golriz9/MarketingSpy/README.md

MarketingSpy
============

Description:
Building a system that can determine which device attracts more customers in an electronics store by counting how many times the item has been picked up, and measuring the average time of pick up. Every time the item is picked up by the customer, the sensor will detect and send the signal to the processor, the processor will process the signal, and display the cumulative count and average time on the LCD.
