golriz9/MarketingSpy/T15_DesignBlockDiagram_V1.0.docx

Design Block Diagram | Bander Alenezi
Team T15 | Anthony Do
Project Tittle: Marketing Spy | Phu Nguyen
Date: Oct 22, 2014 Revision : 1 | Golriz Sedaghat

Object (Input)

Output Display

µController

Sensor

JTAG/ICSP

Power Supply
