golriz9/MarketingSpy/T15_Preliminary_BOM_V1.0.xlsx

Quantity | Component | Manufacturer Part # | Distributer Part# | Descrption | Unit Price $ | Shipping Fee $ | Total $ | Bought From | Sum of Totals
4 | LCD Display |  | IM162 | microtivity IM162 LCD Module 1602, Black on Green with Backlight | $10.99 | $0.00 | $43.96 | AMAZON | $169.03
5 | Microcontroller | ATMEGA168A-AU | 556-ATMEGA168A-AU | 8-bit Microcontrollers - MCU AVR 16KB FL 512B EE 1KB SRAM-20MHz | $2.73 | $7.99 | $35.14 | MOUSER
5 | Voltage Regulator | L7805CV | 511-L7805CV | Linear Voltage Regulators 5.0V 1.0A Positive | $0.59 |  |  | MOUSER
5 | Crystal Oscillator | ECS-160-20-4X | 520-HCU1600-20X | Crystals 16MHz 20pF | $0.53 |  |  | MOUSER
5 | Hall Effect Sensor | SS345PT | 785-SS345PT | Board Mount Hall Effect / Magnetic Sensors SOT-23 SMT 2.7 TO 7Vdc | $1.58 |  |  | MOUSER
2 | Programmer |  |  | Atmel AVRISP Programmer ATAVRISP2 | $24.99 | 0 | $49.98 | eBay
1 | Debugger |  |  |  | $18.00 | $6.99 | $24.99 | eBay
2 | Big Button Input Module |  | BR010025 | Big Button Input Module | $1.50 | $2.32 | $3.00 | Banana Robotic
4 | Track Sensor Module |  | BR010214 | Track Sensor Module | $2.99 |  | $11.96 | Banana Robotic
5 | Voltage Regulator | L7805CDT-TR | 511-L7805CDT-TR | Linear Voltage Regulators 5.0V 1.0A Positive | $0.74 |  |  | Mouser
