golriz9/MarketingSpy/Decision_Matrix.xlsx

 | Weight and Score Key: 1-5, 1 = Failure, 2 = Insufficient, 3 = Mediocre, 4 = Satisfactory, 5 = Excellent, ? = Not enough info to decide
 | Meets the Requirements |  | Cost |  | Design |  | Manufacturing and Implementation |  | Testability |  | Time & Effort Required to Produce |  | Coolness and application |  | Total
Criterion Weight | 5 |  | 3 |  | 4 |  | 4 |  | 5 |  | 5 |  | 2
Ideas | Rationale | Score | Rationale | Score | Rationale | Score | Rationale | Score | Rationale | Score | Rationale | Score | Rationale | Score
Basketball Scorekeeper | Meets "must","should" and "may" requirement | 20 | Moderate cost, no special hardware and software are required | 11.5 | 1- Simple design 2- No special difficulties | 16 | 1. Concern about the location and mounting of the sensor. 2. Error in reading input signal in case the ball spins around the hook but not going through. | 10.5 | 1. Concern about damaging the sensor by ball 2. The pole, basket ball hooks might be required for testing | 10.5 | Does not require extensive amount of time and specialty | 16.5 | Cool, not challenging | 4.5 | 384.5
Marketing Spy | Meets "must","should" and "may" requirement | 20 | 1. The cost may be moderate. The sensor will probably be the most cost effective. 2. No special hardware and software are required | 11.5 | 1. Simple design 2. No special difficulties | 16 | No special hardness | 13.5 | No special difficulty | 17.5 | No specialty | 19 | Cool, not challenging | 4.5 | 444
Karnaugh Map Calculator | Meets "must","should" and "may" requirement | 20 | LCD cost might be high | 9 | 1. The software side of the project may be extensive 2. Complexity of coding is expected | 11.5 | 1. The wiring and soldering may require extensive amount of time. The software side of the project may be extensive as well. 2. May require more wiring and soldering as there are 3 input channel (for 3 variables K-Map) | 10.5 | 1. The testing may take a lot of time to fix the bugs. 2. Hardness in debugging: too many input combinations need to be tested | 12.5 | More time and effort required for coding and testing | 14.5 | Cool and challenging | 8 | 366
Line Follower Robot | Meets "must","should" and "may" requirement | 20 | The additional cost for model (the robot) might be cost effective | 9.25 | 1. The software side of the project may be extensive and time consuming. 2. Mechanical complexity: motors selection, speed control, movement control. 3. Rooms for adding more complexity for future designs to make it more applicable like maze-solving | 11 | 1. The wiring and soldering shouldn't be an issue, but the programming may be time consuming. 2. The involvement of moving parts may require a mechanical skills but not a big concern | 11 | Although the testing procedure is straightforward, the testing may take a lot of time to fix the bugs. | 16 | More time and effort required for coding and testing | 16 | Cool and challenging. It can be developed to real application such as making a toy robot | 10 | 395.75
