golriz9/MarketingSpy/T15_PRI_SYS_V1.5.brd

## EAGLE design T15_PRI_SYS_V1.5.brd (2014-11-08)

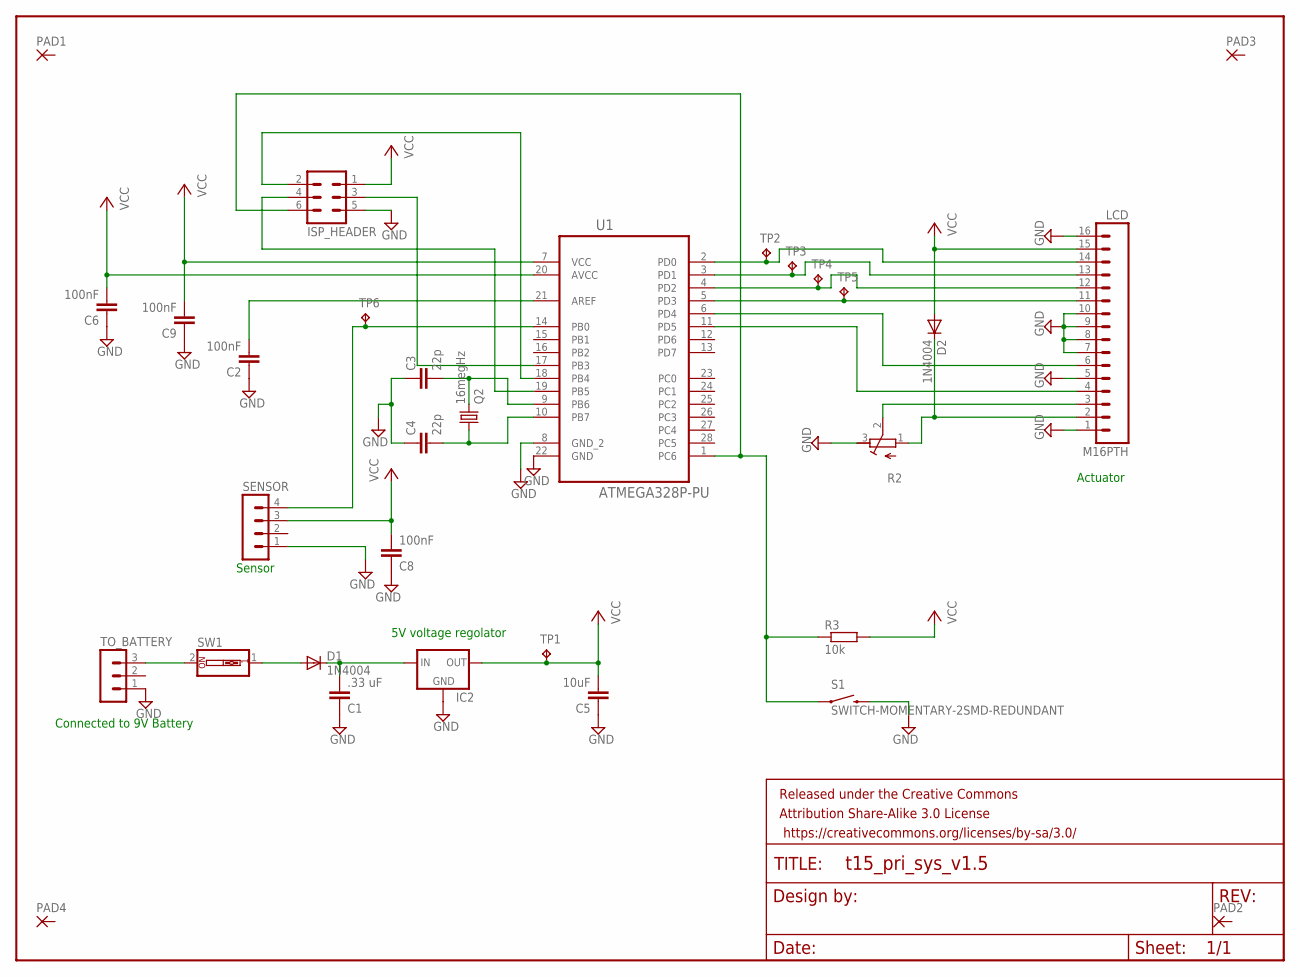
[picture p1: schematic T15_PRI_SYS_V1.5.sch]

Parts:
C1: .33 uF; C025-024X044
C2, C6, C8, C9: 100nF; C025-024X044
C3, C4: 22p; C025-024X044
C5: 10uF; C025-024X044
D1, D2: 1N4004; DO41-10
FRAME1: FRAME-LETTER; CREATIVE_COMMONS
IC2: 78XXL
ISP_HEADER: MA03-2
LCD: M16PTH; 1X16
PAD1, PAD2, PAD3, PAD4: 1,6/0,8
Q2: 16megHz; HC49/S
R2: R-TRIMMTS63Z; RTRIMTS63Z
R3: 10k; 0204/5
S1: SWITCH-MOMENTARY-2SMD-REDUNDANT; TACTILE-SWITCH-SMD
SENSOR: MA04-1
SW1: SW_DIP-1; EDG-01
TO_BATTERY: MA03-1
TP1, TP2, TP3, TP4, TP5, TP6: TPB1,27; B1,27
U1: ATMEGA328P-PU; DIP254P762X457-28

Connections:
GND: C1.1, C2.1, C3.1, C4.1, C5.1, C6.1, C8.1, C9.1, IC2.GND, ISP_HEADER.5, LCD.1, LCD.5, LCD.7, LCD.8, LCD.9, LCD.10, LCD.16, R2.3 (E), S1.3 (2), S1.4 (2), SENSOR.1, TO_BATTERY.1, U1.8 (GND_2), U1.22 (GND)
MISO: ISP_HEADER.2, U1.18 (PB4)
MOSI: ISP_HEADER.3, U1.17 (PB3)
unnamed: D2.C, LCD.2, R2.1 (A)
unnamed: LCD.3, R2.2 (S)
unnamed: C1.2, D1.C, IC2.IN
unnamed: C3.2, Q2.2, U1.9 (PB6)
unnamed: LCD.11, TP5.TP, U1.5 (PD3)
unnamed: C4.2, Q2.1, U1.10 (PB7)
unnamed: LCD.12, TP4.TP, U1.4 (PD2)
unnamed: LCD.13, TP3.TP, U1.3 (PD1)
unnamed: LCD.14, TP2.TP, U1.2 (PD0)
unnamed: SW1.2, TO_BATTERY.3
unnamed: LCD.6, U1.6 (PD4)
unnamed: LCD.4, U1.11 (PD5)
unnamed: D1.A, SW1.1
PBO: SENSOR.4, TP6.TP, U1.14 (PB0)
RESET: ISP_HEADER.6, R3.1, S1.1, S1.2 (1), U1.1 (PC6)
SCK: ISP_HEADER.4, U1.19 (PB5)
VCC: C5.2, C6.2, C8.2, C9.2, D2.A, IC2.OUT, ISP_HEADER.1, LCD.15, R3.2, SENSOR.3, TP1.TP, U1.7 (VCC), U1.20 (AVCC)
VCC1: C2.2, U1.21 (AREF)

Notes on the sheet:
Sensor
Actuator
Connected to 9V Battery
5V voltage regolator

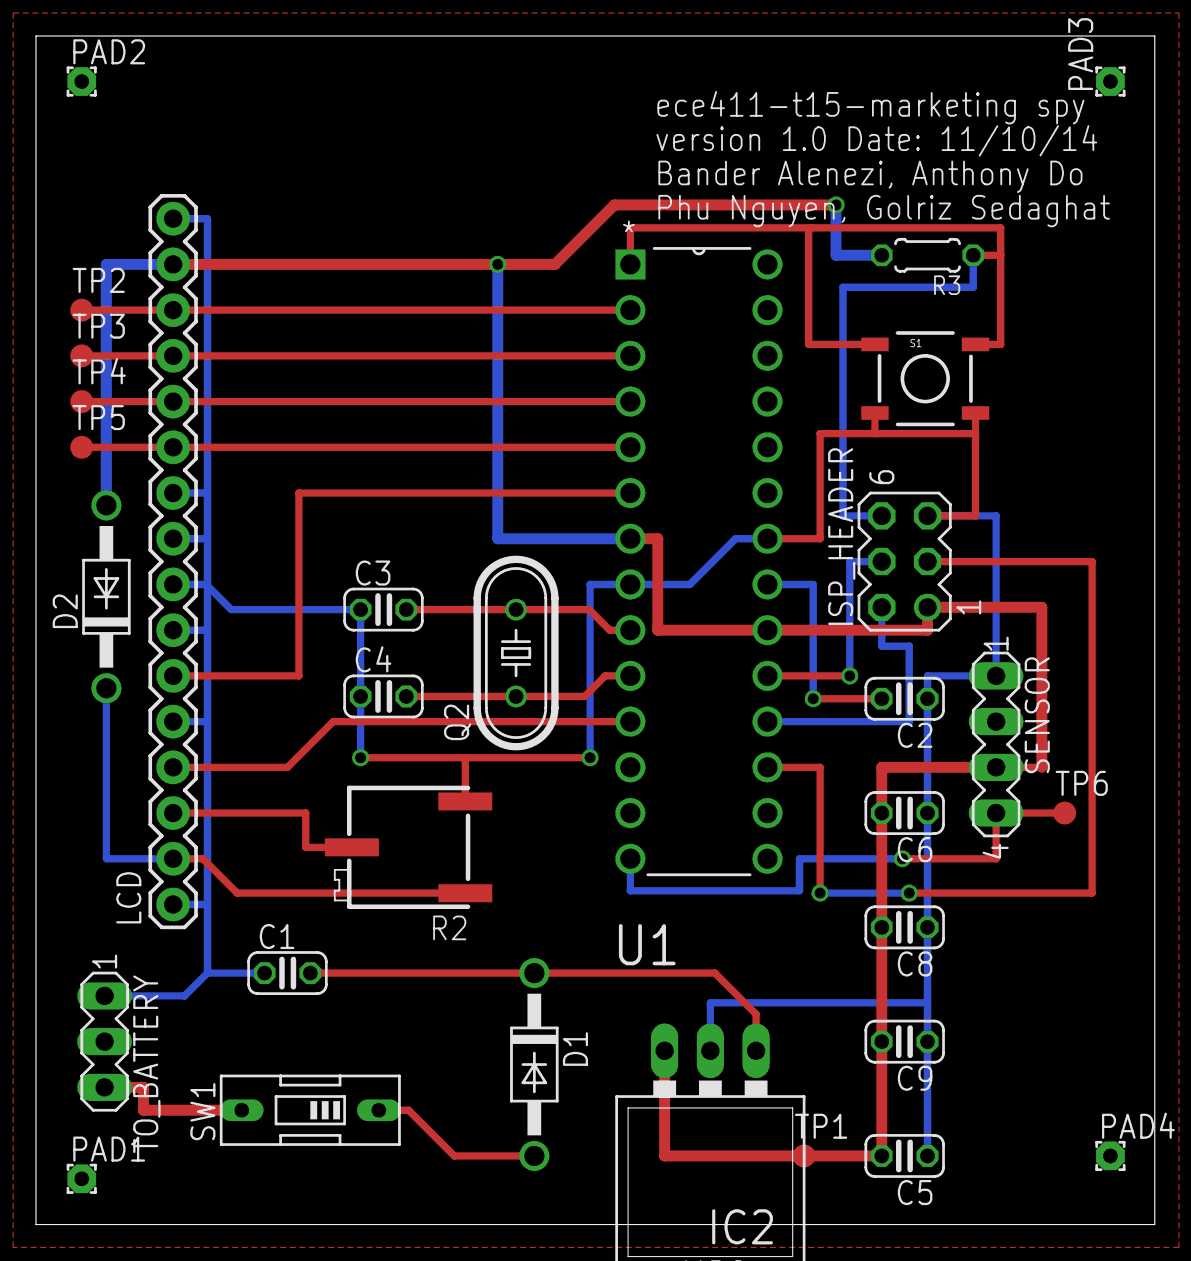
[picture p2: board T15_PRI_SYS_V1.5.brd from above]

Board: 2 copper layers, 62.2 x 66.0 mm, 32 parts (0 on the bottom side), 21 nets.
