golriz9/MarketingSpy/(commit log)

2014-11-08 Decision matrix was added
    [Decision_Matrix.xlsx]
2014-11-08 Bill of material version one was added
    [T15_Preliminary_BOM_V1.0.xlsx]
2014-11-08 The guideline of how to set the ID was added
    [T15_DOC_LOG_V.1.xlsx]
2014-11-08 Document log sheet was added
    [T15_DOC_LOG_V1.0.xlsx]
2014-11-08 Preliminary schematic, version 5, was added
    [T15_PRI_SYS_V1.5.sch]
2014-11-08 PCB layout version 5 was added
    [T15_PRI_SYS_V1.5.brd]
2014-11-08 Schematic version 5 was added
