golriz9/MarketingSpy/(notices)

Notices in the files:
parts and their libraries:
SparkFun-Retired: Licensing:Creative Commons ShareAlike 4.0 International - https://creativecommons.org/licenses/by-sa/4.0
SparkFun-Retired: Released under the Creative Commons Attribution Share-Alike 3.0 License
SparkFun-Retired: https://creativecommons.org/licenses/by-sa/3.0
